roboterclubaachen/reflow-oven/README.md

# reflow-oven

Description: tbd

## Folder structure

#### `pcbs/pcb_name/`
* KiCad files of the PCBs

#### `src/test_*/`
* Test software. Useful during PCB assembly

#### `src/app/`
* Main Software

## License

Software is licensed under [GPLv3](LICENSE).
Hardware (PCB files, ...) is licensed under [CERN OHL v.1.2](LICENSE.hardware).
