roboterclubaachen/reflow-oven/UI_plane.FCStd

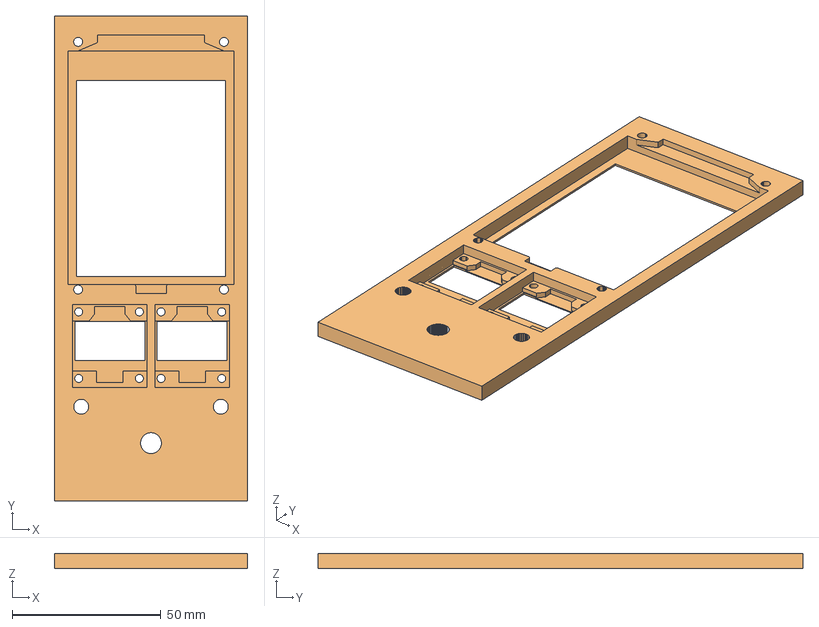
[picture p1: CAD file, 2024-09-06]
UI_plane.FCStd
65.0 x 163.1 x 5.10 mm
Body001 (Meshed)
