roboterclubaachen/reflow-oven/pcbs/reflow-controller-v1/reflow-controller-v1.kicad_pcb

## KiCad design pcbs/reflow-controller-v1/reflow-controller-v1.kicad_pcb (2024-09-22)

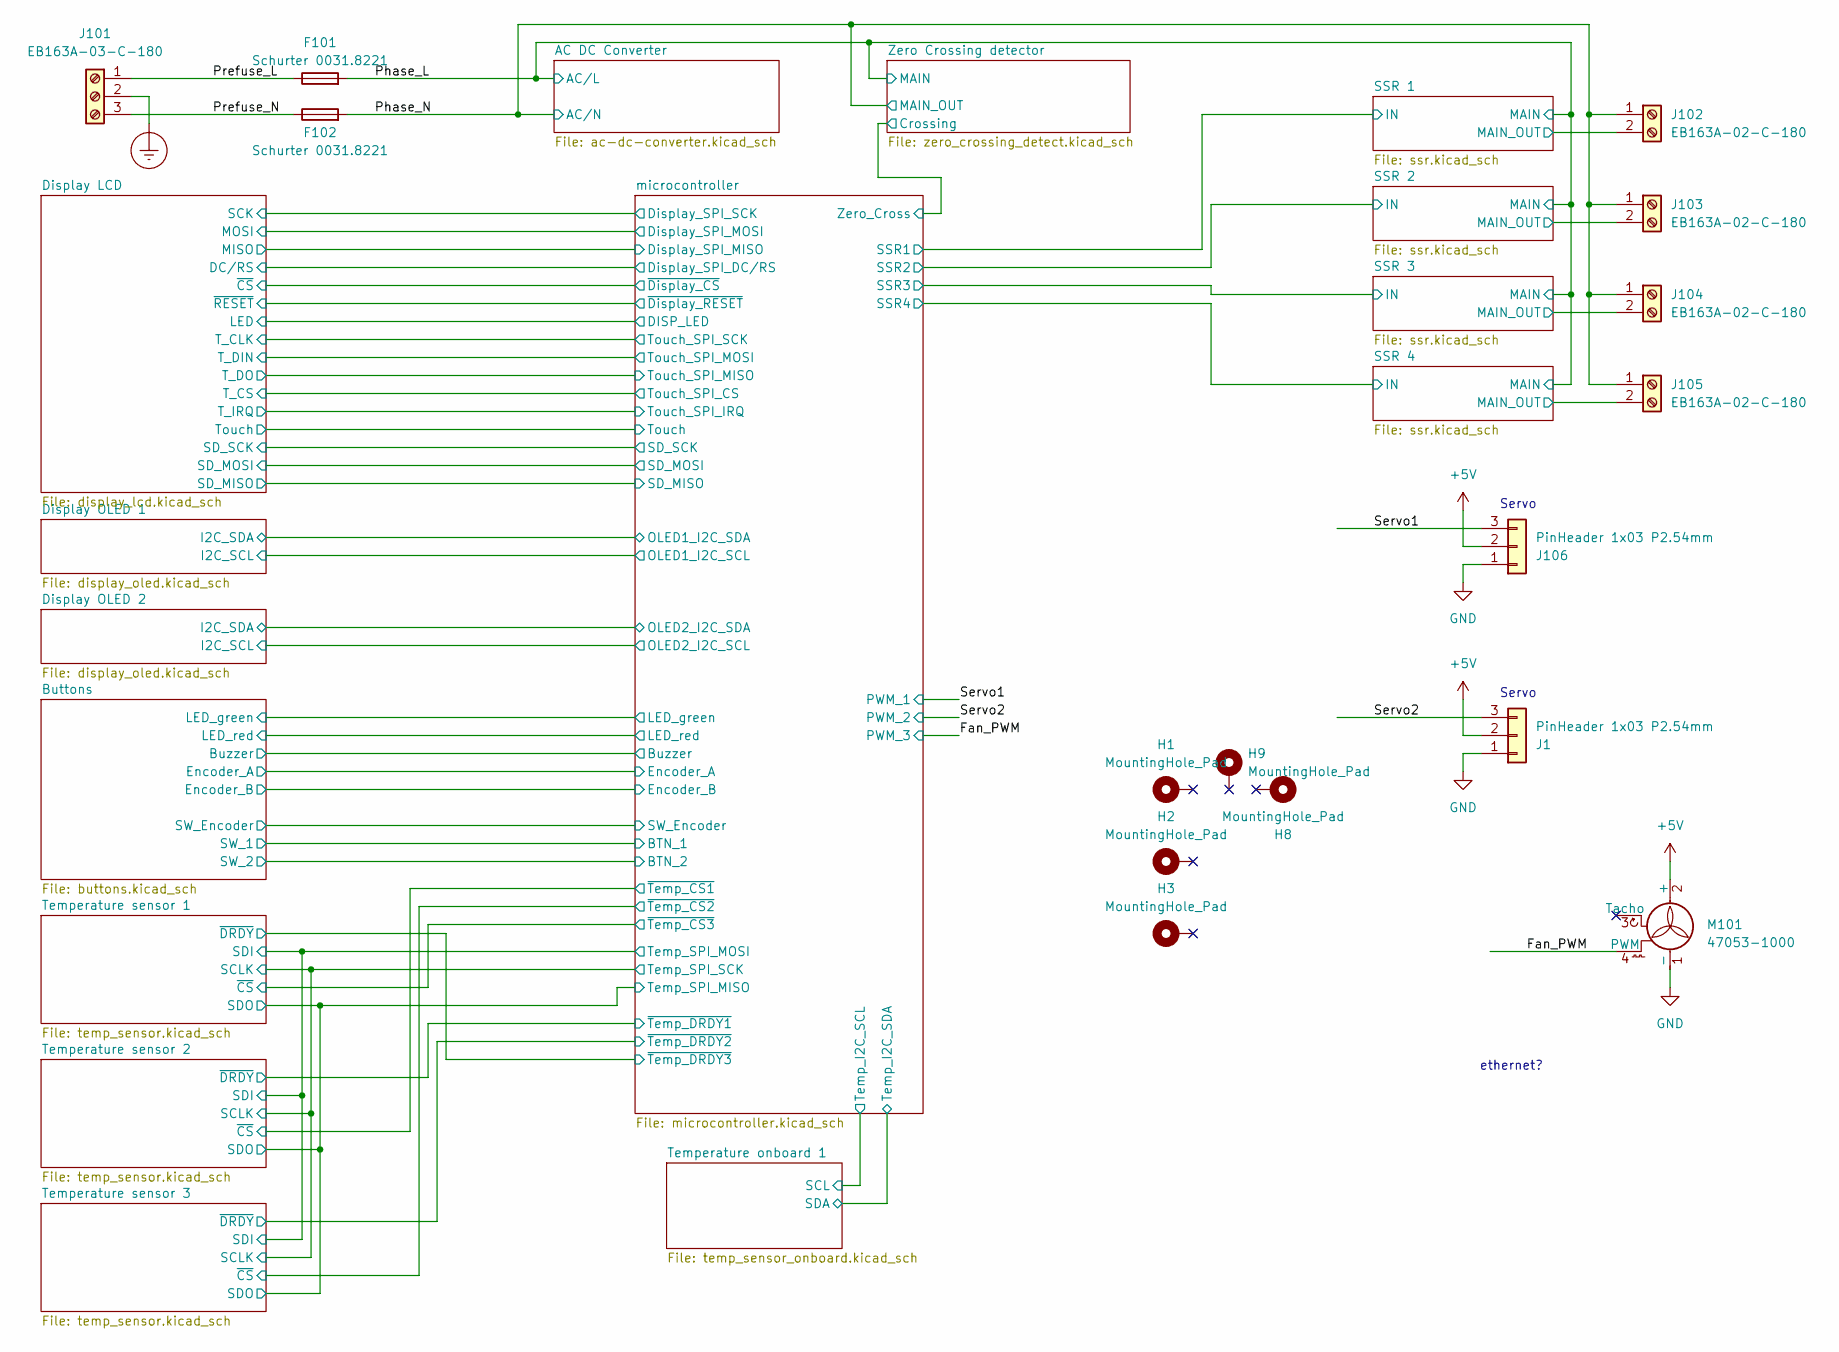
[picture p2: schematic reflow-controller-v1.kicad_sch]

Parts:
F101, F102: Schurter 0031.8221; Fuseholder_Cylinder-5x20mm_Schurter_OGN-SMD_Horizontal_Open
H1, H2, H3, H8, H9: MountingHole_Pad; Mounting_Wuerth_WA-SMSI-M3_H15mm_9774150360
J1, J106: PinHeader 1x03 P2.54mm; PinHeader_1x03_P2.54mm_Vertical
J101: EB163A-03-C-180; PhoenixContact_SPT_2.5_3-V-5.0-EX_1x03_P5.0mm_Vertical
J102, J103, J104, J105: EB163A-02-C-180; PhoenixContact_SPT_2.5_2-V-5.0-EX_1x02_P5.0mm_Vertical
M101: 47053-1000; Molex_KK-254_AE-6410-04A_1x04_P2.54mm_Vertical

Connections:
+5V: J1.2, J106.2, M101.2 (+); also elsewhere on the board
/Fan_PWM: M101.4 (PWM); also elsewhere on the board
/Phase_L: F101.2; also elsewhere on the board
/Phase_N: F102.2, J102.1, J103.1, J104.1, J105.1; also elsewhere on the board
/Prefuse_L: F101.1, J101.1
/Prefuse_N: F102.1, J101.3
/SSR 1/MAIN_OUT: J102.2; also elsewhere on the board
/SSR 2/MAIN_OUT: J103.2; also elsewhere on the board
/SSR 3/MAIN_OUT: J104.2; also elsewhere on the board
/SSR 4/MAIN_OUT: J105.2; also elsewhere on the board
/Servo1: J106.3; also elsewhere on the board
/Servo2: J1.3; also elsewhere on the board
Earth_Protective: J101.2
GND: J1.1, J106.1, M101.1 (-); also elsewhere on the board

Notes on the sheet:
Servo
ethernet?

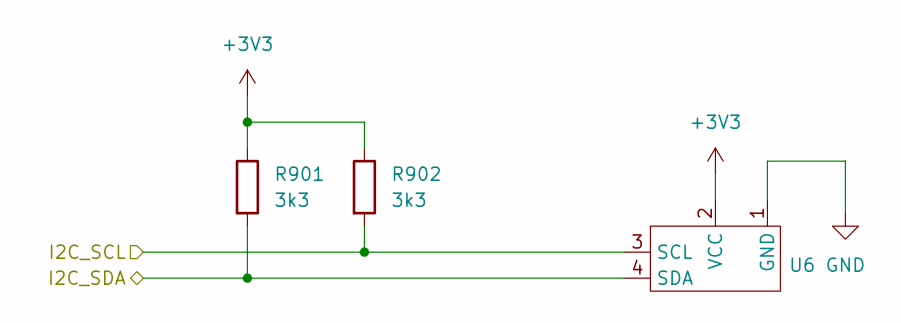
[picture p3: schematic display_oled.kicad_sch]

Parts:
R901, R902: 3k3; R_0603_1608Metric
U6: SSD1315 Module

Connections:
+3V3: R901.1, R902.1, U6.2 (VCC); also elsewhere on the board
/Display OLED 2/I2C_SCL: R902.2, U6.3 (SCL); also elsewhere on the board
/Display OLED 2/I2C_SDA: R901.2, U6.4 (SDA); also elsewhere on the board
GND: U6.1 (GND); also elsewhere on the board

Parts of its further copies:
R801, R802: 3k3; R_0603_1608Metric
U5: SSD1315 Module

Connections of its further copies:
+3V3: R801.1, R802.1, U5.2 (VCC); also elsewhere on the board
/Display OLED 1/I2C_SCL: R802.2, U5.3 (SCL); also elsewhere on the board
/Display OLED 1/I2C_SDA: R801.2, U5.4 (SDA); also elsewhere on the board
GND: U5.1 (GND); also elsewhere on the board

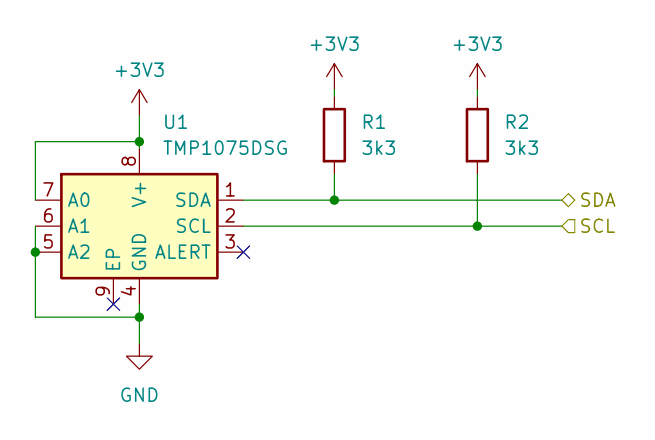
[picture p4: schematic temp_sensor_onboard.kicad_sch]

Parts:
R1, R2: 3k3; R_0603_1608Metric
U1: TMP1075DSG; WSON-8-1EP_2x2mm_P0.5mm_EP0.9x1.6mm_ThermalVias

Connections:
+3V3: R1.1, R2.1, U1.7 (A0), U1.8 (V+); also elsewhere on the board
/Temperature onboard 1/SCL: R2.2, U1.2 (SCL); also elsewhere on the board
/Temperature onboard 1/SDA: R1.2, U1.1 (SDA); also elsewhere on the board
GND: U1.4 (GND), U1.5 (A2), U1.6 (A1); also elsewhere on the board

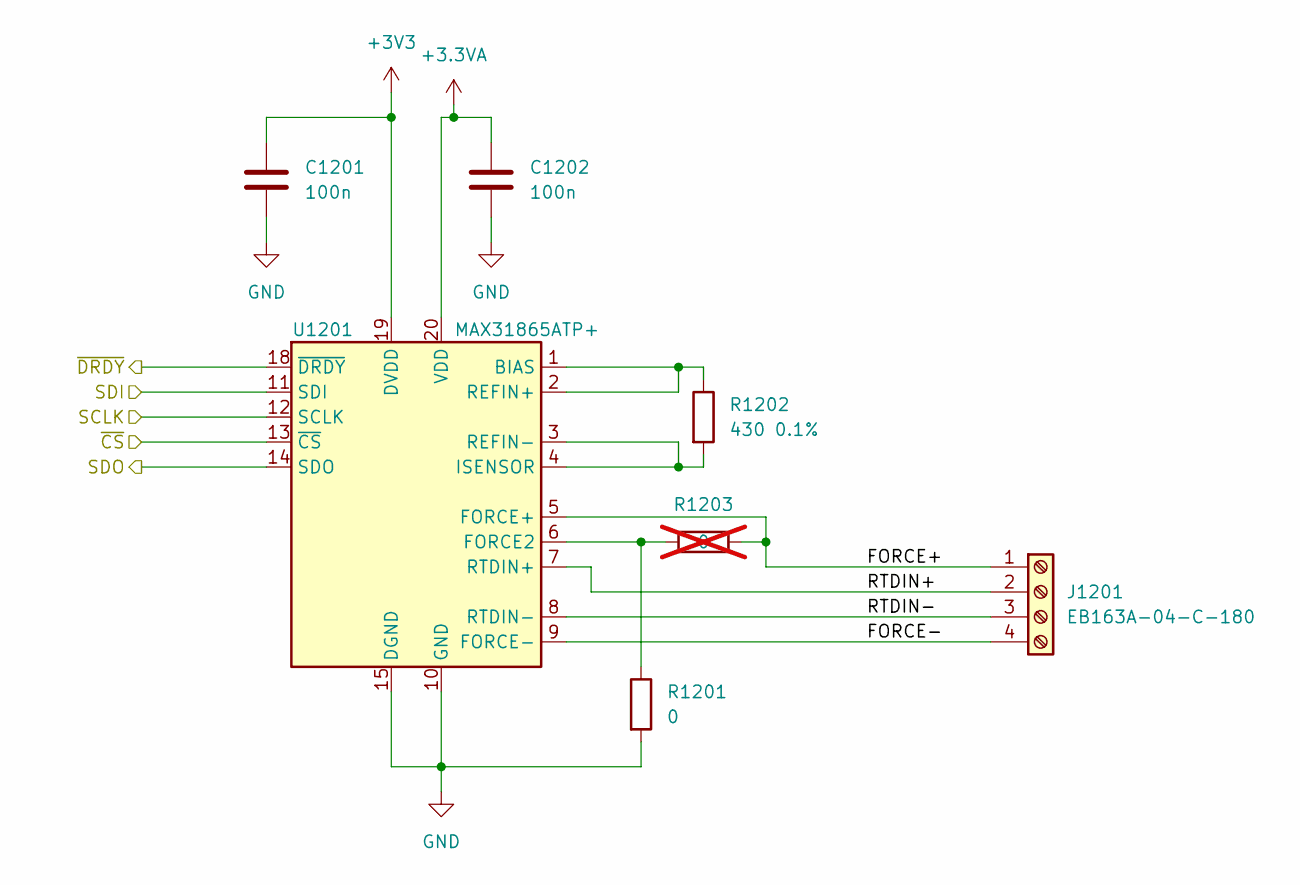
[picture p5: schematic temp_sensor.kicad_sch]

Parts:
C1201, C1202: 100n; C_0603_1608Metric
J1201: EB163A-04-C-180; PhoenixContact_SPT_2.5_4-V-5.0-EX_1x04_P5.0mm_Vertical
R1201: 0; R_0603_1608Metric
R1202: 430 0.1%; R_1206_3216Metric
R1203: 0; R_0603_1608Metric; not fitted
U1201: MAX31865ATP+; TQFN-20-1EP_5x5mm_P0.65mm_EP3.25x3.25mm

Connections:
+3.3VA: C1202.1, U1201.20 (VDD); also elsewhere on the board
+3V3: C1201.1, U1201.19 (DVDD); also elsewhere on the board
/Temperature sensor 1/SCLK: U1201.12 (SCLK); also elsewhere on the board
/Temperature sensor 1/SDI: U1201.11 (SDI); also elsewhere on the board
/Temperature sensor 1/SDO: U1201.14 (SDO); also elsewhere on the board
/Temperature sensor 2/FORCE+: J1201.1, R1203.2, U1201.5 (FORCE+)
/Temperature sensor 2/FORCE-: J1201.4, U1201.9 (FORCE-)
/Temperature sensor 2/RTDIN+: J1201.2, U1201.7 (RTDIN+)
/Temperature sensor 2/RTDIN-: J1201.3, U1201.8 (RTDIN-)
/Temperature sensor 2/~CS: U1201.13 (~CS); also elsewhere on the board
/Temperature sensor 2/~DRDY: U1201.18 (~DRDY); also elsewhere on the board
GND: C1201.2, C1202.2, R1201.2, U1201.10 (GND), U1201.15 (DGND), U1201.16 (GND), U1201.21 (GND); also elsewhere on the board
unnamed: R1202.1, U1201.1 (BIAS), U1201.2 (REFIN+)
unnamed: R1201.1, R1203.1, U1201.6 (FORCE2)
unnamed: R1202.2, U1201.3 (REFIN-), U1201.4 (ISENSOR)

Parts of its further copies:
C1101, C1102, C1301, C1302: 100n; C_0603_1608Metric
J1101, J1301: EB163A-04-C-180; PhoenixContact_SPT_2.5_4-V-5.0-EX_1x04_P5.0mm_Vertical
R1101, R1302: 430 0.1%; R_1206_3216Metric
R1102, R1301: 0; R_0603_1608Metric
R1103, R1303: 0; R_0603_1608Metric; not fitted
U1101, U1301: MAX31865ATP+; TQFN-20-1EP_5x5mm_P0.65mm_EP3.25x3.25mm

Connections of its further copies:
+3.3VA: C1101.1, C1302.1, U1101.20 (VDD), U1301.20 (VDD); also elsewhere on the board
+3V3: C1102.1, C1301.1, U1101.19 (DVDD), U1301.19 (DVDD); also elsewhere on the board
/Temperature sensor 1/FORCE+: J1101.1, R1103.2, U1101.5 (FORCE+)
/Temperature sensor 1/FORCE-: J1101.4, U1101.9 (FORCE-)
/Temperature sensor 1/RTDIN+: J1101.2, U1101.7 (RTDIN+)
/Temperature sensor 1/RTDIN-: J1101.3, U1101.8 (RTDIN-)
/Temperature sensor 1/SCLK: U1101.12 (SCLK), U1301.12 (SCLK); also elsewhere on the board
/Temperature sensor 1/SDI: U1101.11 (SDI), U1301.11 (SDI); also elsewhere on the board
/Temperature sensor 1/SDO: U1101.14 (SDO), U1301.14 (SDO); also elsewhere on the board
/Temperature sensor 1/~CS: U1101.13 (~CS); also elsewhere on the board
/Temperature sensor 1/~DRDY: U1101.18 (~DRDY); also elsewhere on the board
/Temperature sensor 3/FORCE+: J1301.1, R1303.2, U1301.5 (FORCE+)
/Temperature sensor 3/FORCE-: J1301.4, U1301.9 (FORCE-)
/Temperature sensor 3/RTDIN+: J1301.2, U1301.7 (RTDIN+)
/Temperature sensor 3/RTDIN-: J1301.3, U1301.8 (RTDIN-)
/Temperature sensor 3/~CS: U1301.13 (~CS); also elsewhere on the board
/Temperature sensor 3/~DRDY: U1301.18 (~DRDY); also elsewhere on the board
GND: C1101.2, C1102.2, C1301.2, C1302.2, R1102.2, R1301.2, U1101.10 (GND), U1101.15 (DGND), U1101.16 (GND), U1101.21 (GND), U1301.10 (GND), U1301.15 (DGND), U1301.16 (GND), U1301.21 (GND); also elsewhere on the board
unnamed: R1101.1, U1101.1 (BIAS), U1101.2 (REFIN+)
unnamed: R1102.1, R1103.1, U1101.6 (FORCE2)
unnamed: R1101.2, U1101.3 (REFIN-), U1101.4 (ISENSOR)
unnamed: R1302.1, U1301.1 (BIAS), U1301.2 (REFIN+)
unnamed: R1301.1, R1303.1, U1301.6 (FORCE2)
unnamed: R1302.2, U1301.3 (REFIN-), U1301.4 (ISENSOR)

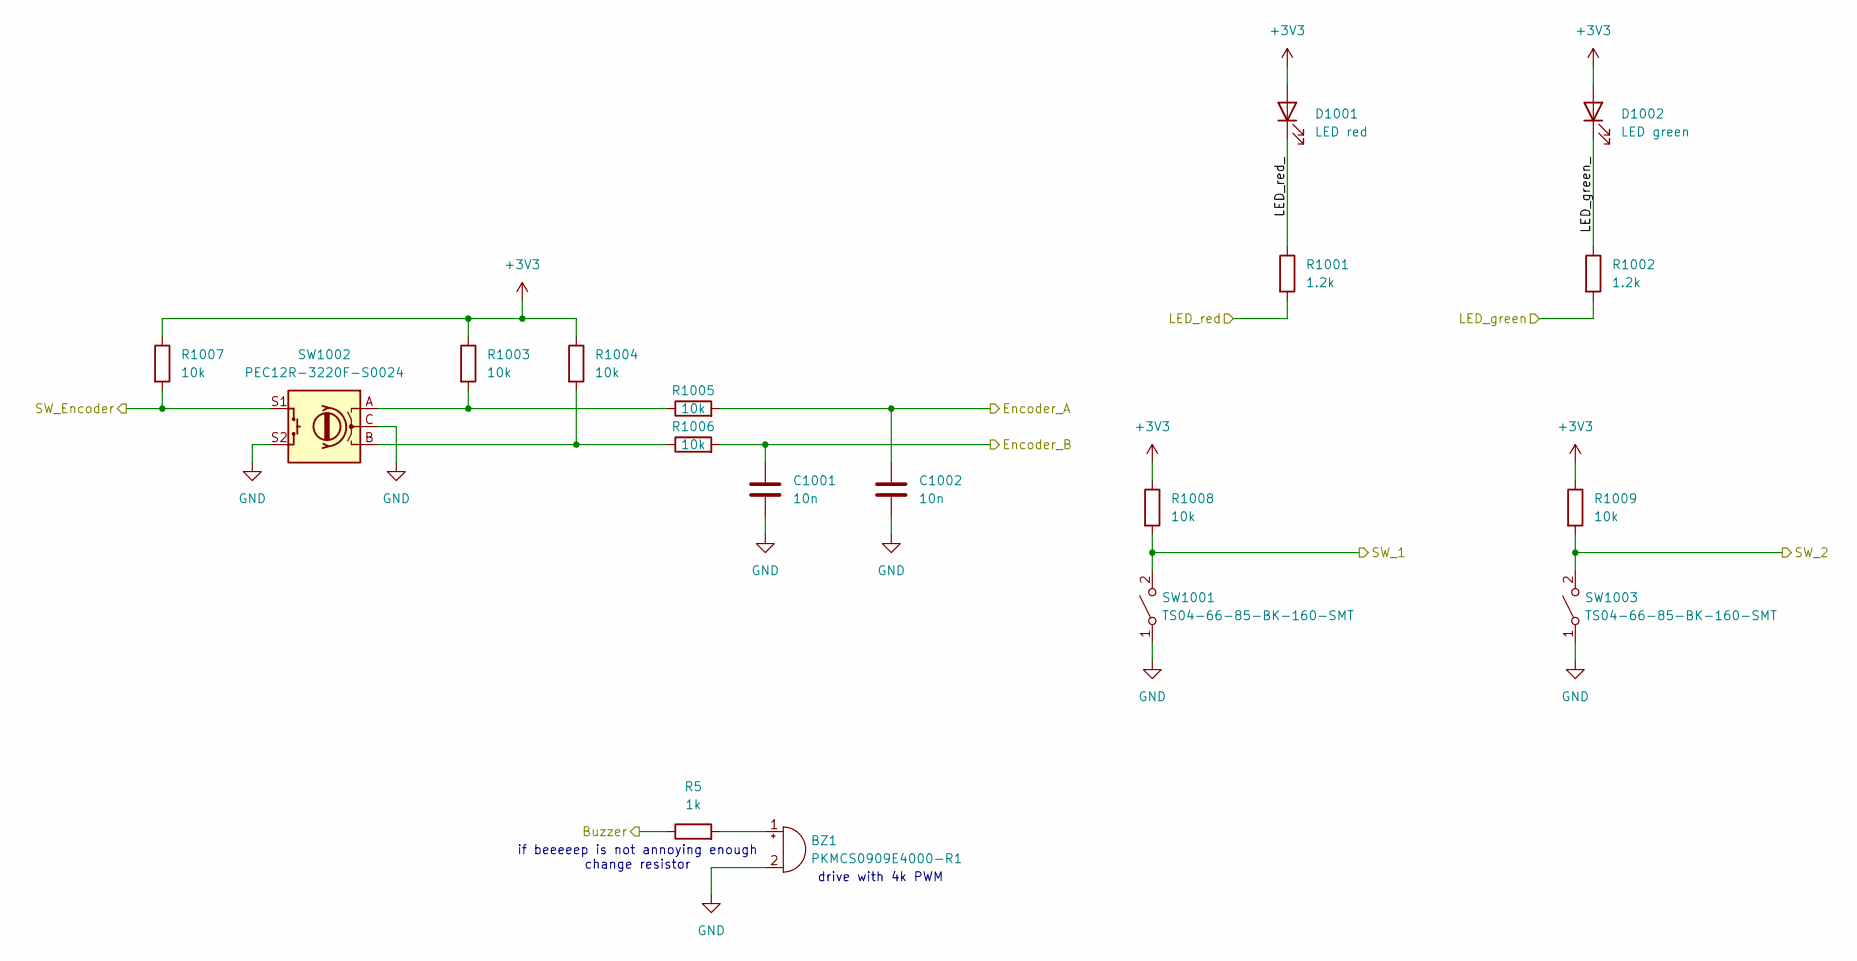
[picture p6: schematic buttons.kicad_sch]

Parts:
BZ1: PKMCS0909E4000-R1; Buzzer_Murata_PKMCS0909E
C1001, C1002: 10n; C_0603_1608Metric
D1001: LED red; LED_0603_1608Metric
D1002: LED green; LED_0603_1608Metric
R5: 1k; R_0603_1608Metric
R1001, R1002: 1.2k; R_0603_1608Metric
R1003, R1004, R1005, R1006, R1007, R1008, R1009: 10k; R_0603_1608Metric
SW1001, SW1003: TS04-66-85-BK-160-SMT; SW_Push_1P1T_NO_6x6mm_H9.5mm
SW1002: PEC12R-3220F-S0024; RotaryEncoder_Bourns_Vertical_PEC12R-3x17F-Sxxxx

Connections:
+3V3: D1001.2 (A), D1002.2 (A), R1003.1, R1004.1, R1007.1, R1008.1, R1009.1; also elsewhere on the board
/Buttons/Buzzer: R5.1; also elsewhere on the board
/Buttons/Encoder_A: C1002.1, R1005.2; also elsewhere on the board
/Buttons/Encoder_B: C1001.1, R1006.2; also elsewhere on the board
/Buttons/LED_green: R1002.2; also elsewhere on the board
/Buttons/LED_green_: D1002.1 (K), R1002.1
/Buttons/LED_red: R1001.2; also elsewhere on the board
/Buttons/LED_red_: D1001.1 (K), R1001.1
/Buttons/SW_1: R1008.2, SW1001.2 (B); also elsewhere on the board
/Buttons/SW_2: R1009.2, SW1003.2 (B); also elsewhere on the board
/Buttons/SW_Encoder: R1007.2, SW1002.S1; also elsewhere on the board
GND: BZ1.2 (-), C1001.2, C1002.2, SW1001.1 (A), SW1002.C, SW1002.S2, SW1003.1 (A); also elsewhere on the board
unnamed: BZ1.1 (+), R5.2
unnamed: R1003.2, R1005.1, SW1002.A
unnamed: R1004.2, R1006.1, SW1002.B

Notes on the sheet:
if beeeeep is not annoying enough change resistor
drive with 4k PWM

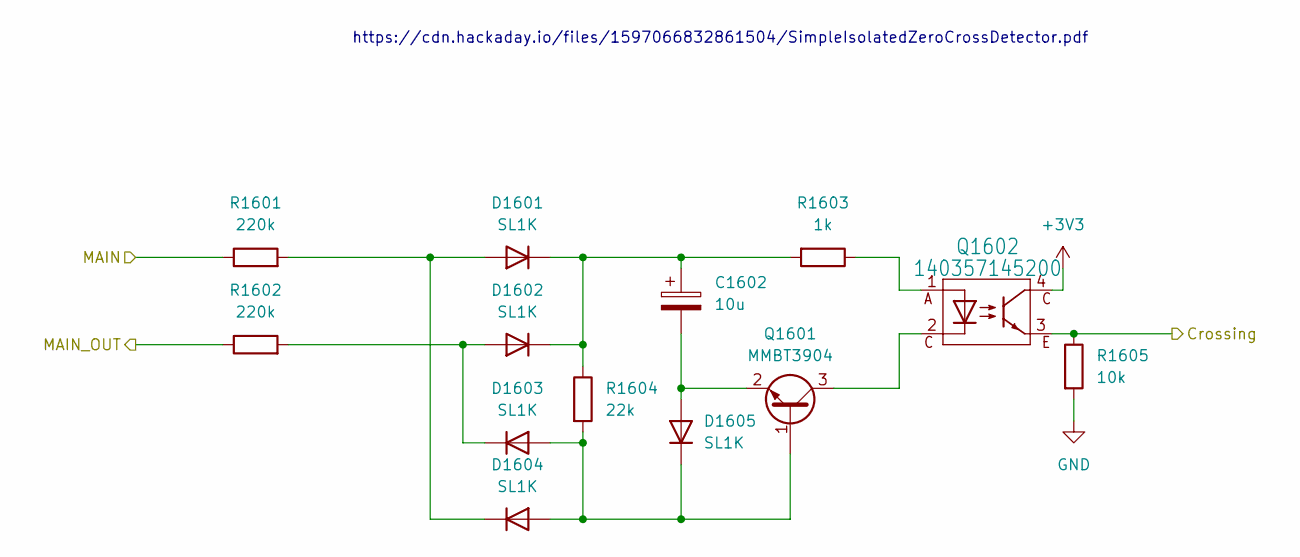
[picture p7: schematic zero_crossing_detect.kicad_sch]

Parts:
C1602: 10u; CP_Elec_4x5.7
D1601, D1602, D1603, D1604, D1605: SL1K; D_SOD-123F
Q1601: MMBT3904; SOT-23
Q1602: 140357145200; WL-OCPT_LSOP4
R1601, R1602: 220k; R_1206_3216Metric
R1603: 1k; R_0603_1608Metric
R1604: 22k; R_0603_1608Metric
R1605: 10k; R_0603_1608Metric

Connections:
+3V3: Q1602.4; also elsewhere on the board
/Phase_L: R1601.1; also elsewhere on the board
/Phase_N: R1602.1; also elsewhere on the board
/Zero Crossing detector/Crossing: Q1602.3, R1605.1; also elsewhere on the board
GND: R1605.2; also elsewhere on the board
unnamed: D1601.2 (A), D1604.1 (K), R1601.2
unnamed: C1602.1, D1601.1 (K), D1602.1 (K), R1603.2, R1604.1
unnamed: D1602.2 (A), D1603.1 (K), R1602.2
unnamed: D1603.2 (A), D1604.2 (A), D1605.1 (K), Q1601.1 (B), R1604.2
unnamed: C1602.2, D1605.2 (A), Q1601.2 (E)
unnamed: Q1601.3 (C), Q1602.2
unnamed: Q1602.1, R1603.1

Notes on the sheet:
https://cdn.hackaday.io/files/1597066832861504/SimpleIsolatedZeroCrossDetector.pdf

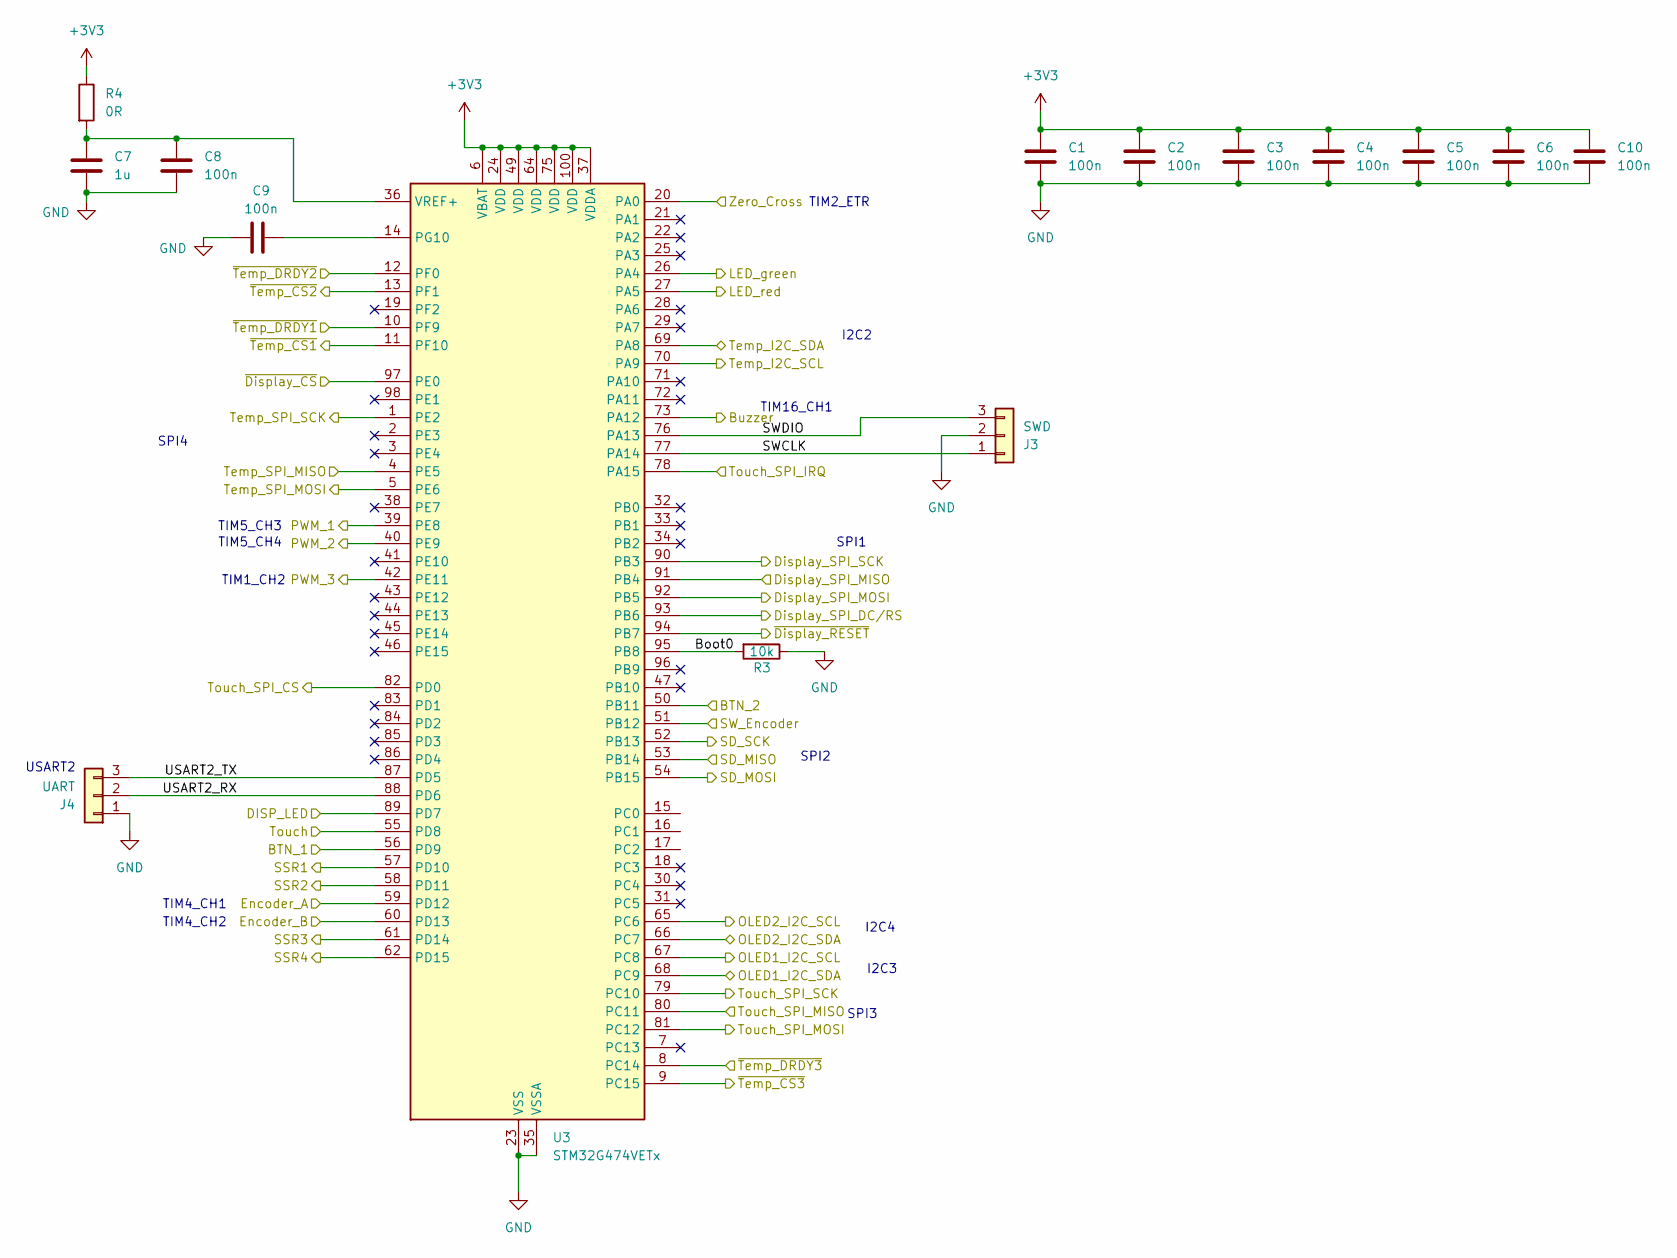
[picture p8: schematic microcontroller.kicad_sch]

Parts:
C1, C2, C3, C4, C5, C6, C8, C9, C10: 100n; C_0603_1608Metric
C7: 1u; C_0603_1608Metric
J3: SWD; Molex_KK-254_AE-6410-03A_1x03_P2.54mm_Vertical
J4: UART; Molex_KK-254_AE-6410-03A_1x03_P2.54mm_Vertical
R3: 10k; R_0603_1608Metric
R4: 0R; R_0603_1608Metric
U3: STM32G474VETx; LQFP-100_14x14mm_P0.5mm

Connections:
+3V3: C1.1, C2.1, C3.1, C4.1, C5.1, C6.1, C10.1, R4.1, U3.6 (VBAT), U3.24 (VDD), U3.37 (VDDA), U3.49 (VDD), U3.64 (VDD), U3.75 (VDD), U3.100 (VDD); also elsewhere on the board
/Buttons/Buzzer: U3.73 (PA12); also elsewhere on the board
/Buttons/Encoder_A: U3.59 (PD12); also elsewhere on the board
/Buttons/Encoder_B: U3.60 (PD13); also elsewhere on the board
/Buttons/LED_green: U3.26 (PA4); also elsewhere on the board
/Buttons/LED_red: U3.27 (PA5); also elsewhere on the board
/Buttons/SW_1: U3.56 (PD9); also elsewhere on the board
/Buttons/SW_2: U3.50 (PB11); also elsewhere on the board
/Buttons/SW_Encoder: U3.51 (PB12); also elsewhere on the board
/Display LCD/DC/RS: U3.93 (PB6); also elsewhere on the board
/Display LCD/LED: U3.89 (PD7); also elsewhere on the board
/Display LCD/MISO: U3.91 (PB4); also elsewhere on the board
/Display LCD/MOSI: U3.92 (PB5); also elsewhere on the board
/Display LCD/SCK: U3.90 (PB3); also elsewhere on the board
/Display LCD/SD_MISO: U3.53 (PB14); also elsewhere on the board
/Display LCD/SD_MOSI: U3.54 (PB15); also elsewhere on the board
/Display LCD/SD_SCK: U3.52 (PB13); also elsewhere on the board
/Display LCD/T_CLK: U3.79 (PC10); also elsewhere on the board
/Display LCD/T_CS: U3.82 (PD0); also elsewhere on the board
/Display LCD/T_DIN: U3.81 (PC12); also elsewhere on the board
/Display LCD/T_DO: U3.80 (PC11); also elsewhere on the board
/Display LCD/T_IRQ: U3.78 (PA15); also elsewhere on the board
/Display LCD/Touch: U3.55 (PD8); also elsewhere on the board
/Display LCD/~CS: U3.97 (PE0); also elsewhere on the board
/Display LCD/~RESET: U3.94 (PB7); also elsewhere on the board
/Display OLED 1/I2C_SCL: U3.67 (PC8); also elsewhere on the board
/Display OLED 1/I2C_SDA: U3.68 (PC9); also elsewhere on the board
/Display OLED 2/I2C_SCL: U3.65 (PC6); also elsewhere on the board
/Display OLED 2/I2C_SDA: U3.66 (PC7); also elsewhere on the board
/Fan_PWM: U3.42 (PE11); also elsewhere on the board
/SSR 1/IN: U3.57 (PD10); also elsewhere on the board
/SSR 2/IN: U3.58 (PD11); also elsewhere on the board
/SSR 3/IN: U3.61 (PD14); also elsewhere on the board
/SSR 4/IN: U3.62 (PD15); also elsewhere on the board
/Servo1: U3.39 (PE8); also elsewhere on the board
/Servo2: U3.40 (PE9); also elsewhere on the board
/Temperature onboard 1/SCL: U3.70 (PA9); also elsewhere on the board
/Temperature onboard 1/SDA: U3.69 (PA8); also elsewhere on the board
/Temperature sensor 1/SCLK: U3.1 (PE2); also elsewhere on the board
/Temperature sensor 1/SDI: U3.5 (PE6); also elsewhere on the board
/Temperature sensor 1/SDO: U3.4 (PE5); also elsewhere on the board
/Temperature sensor 1/~CS: U3.9 (PC15); also elsewhere on the board
/Temperature sensor 1/~DRDY: U3.8 (PC14); also elsewhere on the board
/Temperature sensor 2/~CS: U3.11 (PF10); also elsewhere on the board
/Temperature sensor 2/~DRDY: U3.10 (PF9); also elsewhere on the board
/Temperature sensor 3/~CS: U3.13 (PF1); also elsewhere on the board
/Temperature sensor 3/~DRDY: U3.12 (PF0); also elsewhere on the board
/Zero Crossing detector/Crossing: U3.20 (PA0); also elsewhere on the board
/microcontroller/Boot0: R3.2, U3.95 (PB8)
/microcontroller/SWCLK: J3.1, U3.77 (PA14)
/microcontroller/SWDIO: J3.3, U3.76 (PA13)
/microcontroller/USART2_RX: J4.2, U3.88 (PD6)
/microcontroller/USART2_TX: J4.3, U3.87 (PD5)
GND: C1.2, C2.2, C3.2, C4.2, C5.2, C6.2, C7.2, C8.2, C9.1, C10.2, J3.2, J4.1, R3.1, U3.23 (VSS), U3.35 (VSSA), U3.48 (VSS), U3.63 (VSS), U3.74 (VSS), U3.99 (VSS); also elsewhere on the board
unnamed: C9.2, U3.14 (PG10)
unnamed: C7.1, C8.1, R4.2, U3.36 (VREF+)

Notes on the sheet:
SPI4
TIM2_ETR
TIM5_CH3
TIM4_CH2
SPI3
I2C4
I2C2
SPI2
TIM16_CH1
TIM4_CH1
SPI1
I2C3
USART2
TIM5_CH4
TIM1_CH2

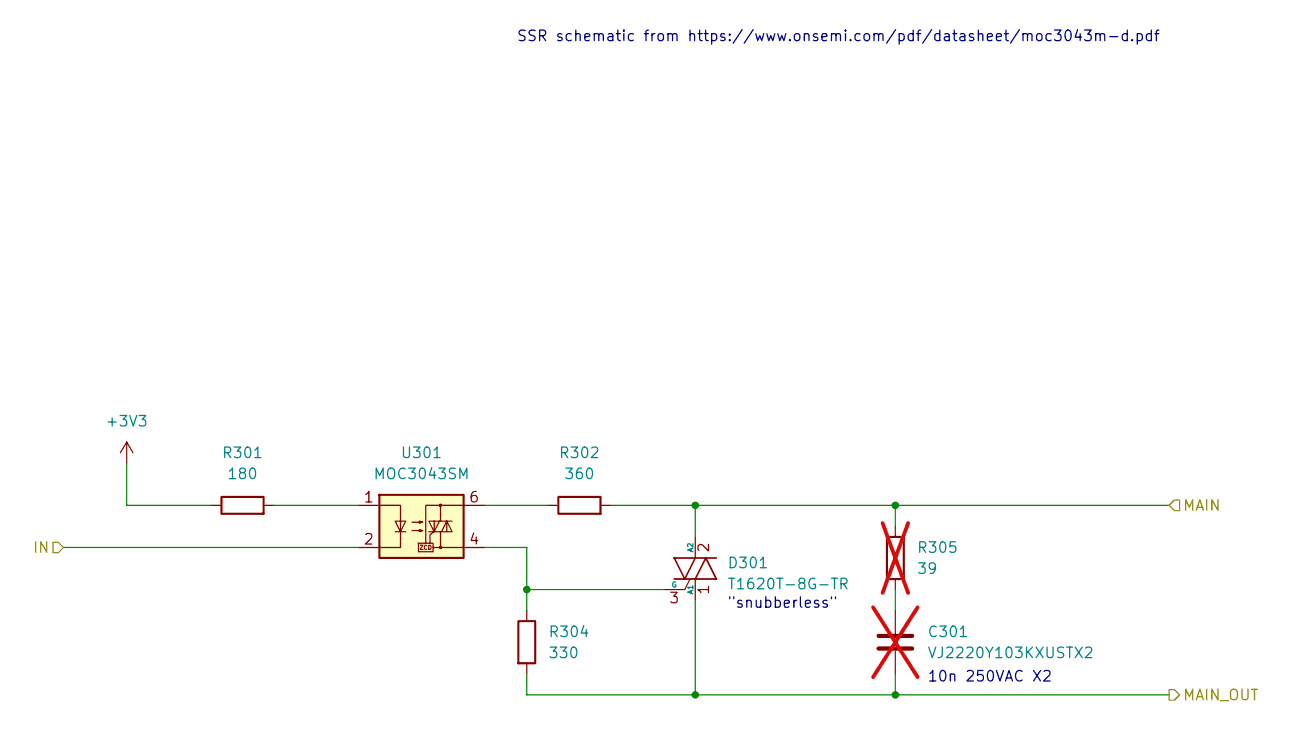
[picture p9: schematic ssr.kicad_sch]

Parts:
C301: VJ2220Y103KXUSTX2; C_2220_5750Metric; not fitted
D301: T1620T-8G-TR; TO-263-2
R301: 180; R_0603_1608Metric
R302: 360; R_1206_3216Metric
R304: 330; R_1206_3216Metric
R305: 39; R_1206_3216Metric; not fitted
U301: MOC3043SM; DIP-6_W7.62mm_SMDSocket_SmallPads

Connections:
+3V3: R301.1; also elsewhere on the board
/Phase_L: D301.2 (A2), R302.2, R305.1; also elsewhere on the board
/SSR 1/IN: U301.2; also elsewhere on the board
/SSR 1/MAIN_OUT: C301.2, D301.1 (A1), R304.2; also elsewhere on the board
unnamed: C301.1, R305.2
unnamed: D301.3 (G), R304.1, U301.4
unnamed: R301.2, U301.1
unnamed: R302.1, U301.6

Parts of its further copies:
C401, C501, C601: VJ2220Y103KXUSTX2; C_2220_5750Metric; not fitted
D401, D501, D601: T1620T-8G-TR; TO-263-2
R401, R501, R601: 180; R_0603_1608Metric
R402, R502, R602: 330; R_1206_3216Metric
R403, R503, R603: 360; R_1206_3216Metric
R404, R504, R604: 39; R_1206_3216Metric; not fitted
U401, U501, U601: MOC3043SM; DIP-6_W7.62mm_SMDSocket_SmallPads

Connections of its further copies:
+3V3: R401.1, R501.1, R601.1; also elsewhere on the board
/Phase_L: D401.2 (A2), D501.2 (A2), D601.2 (A2), R403.2, R404.1, R503.2, R504.1, R603.2, R604.1; also elsewhere on the board
/SSR 2/IN: U401.2; also elsewhere on the board
/SSR 2/MAIN_OUT: C401.2, D401.1 (A1), R402.2; also elsewhere on the board
/SSR 3/IN: U501.2; also elsewhere on the board
/SSR 3/MAIN_OUT: C501.2, D501.1 (A1), R502.2; also elsewhere on the board
/SSR 4/IN: U601.2; also elsewhere on the board
/SSR 4/MAIN_OUT: C601.2, D601.1 (A1), R602.2; also elsewhere on the board
unnamed: C401.1, R404.2
unnamed: C501.1, R504.2
unnamed: C601.1, R604.2
unnamed: D401.3 (G), R402.1, U401.4
unnamed: D501.3 (G), R502.1, U501.4
unnamed: D601.3 (G), R602.1, U601.4
unnamed: R401.2, U401.1
unnamed: R403.1, U401.6
unnamed: R501.2, U501.1
unnamed: R503.1, U501.6
unnamed: R601.2, U601.1
unnamed: R603.1, U601.6

Notes on the sheet:
"snubberless"
SSR schematic from https://www.onsemi.com/pdf/datasheet/moc3043m-d.pdf
10n 250VAC X2

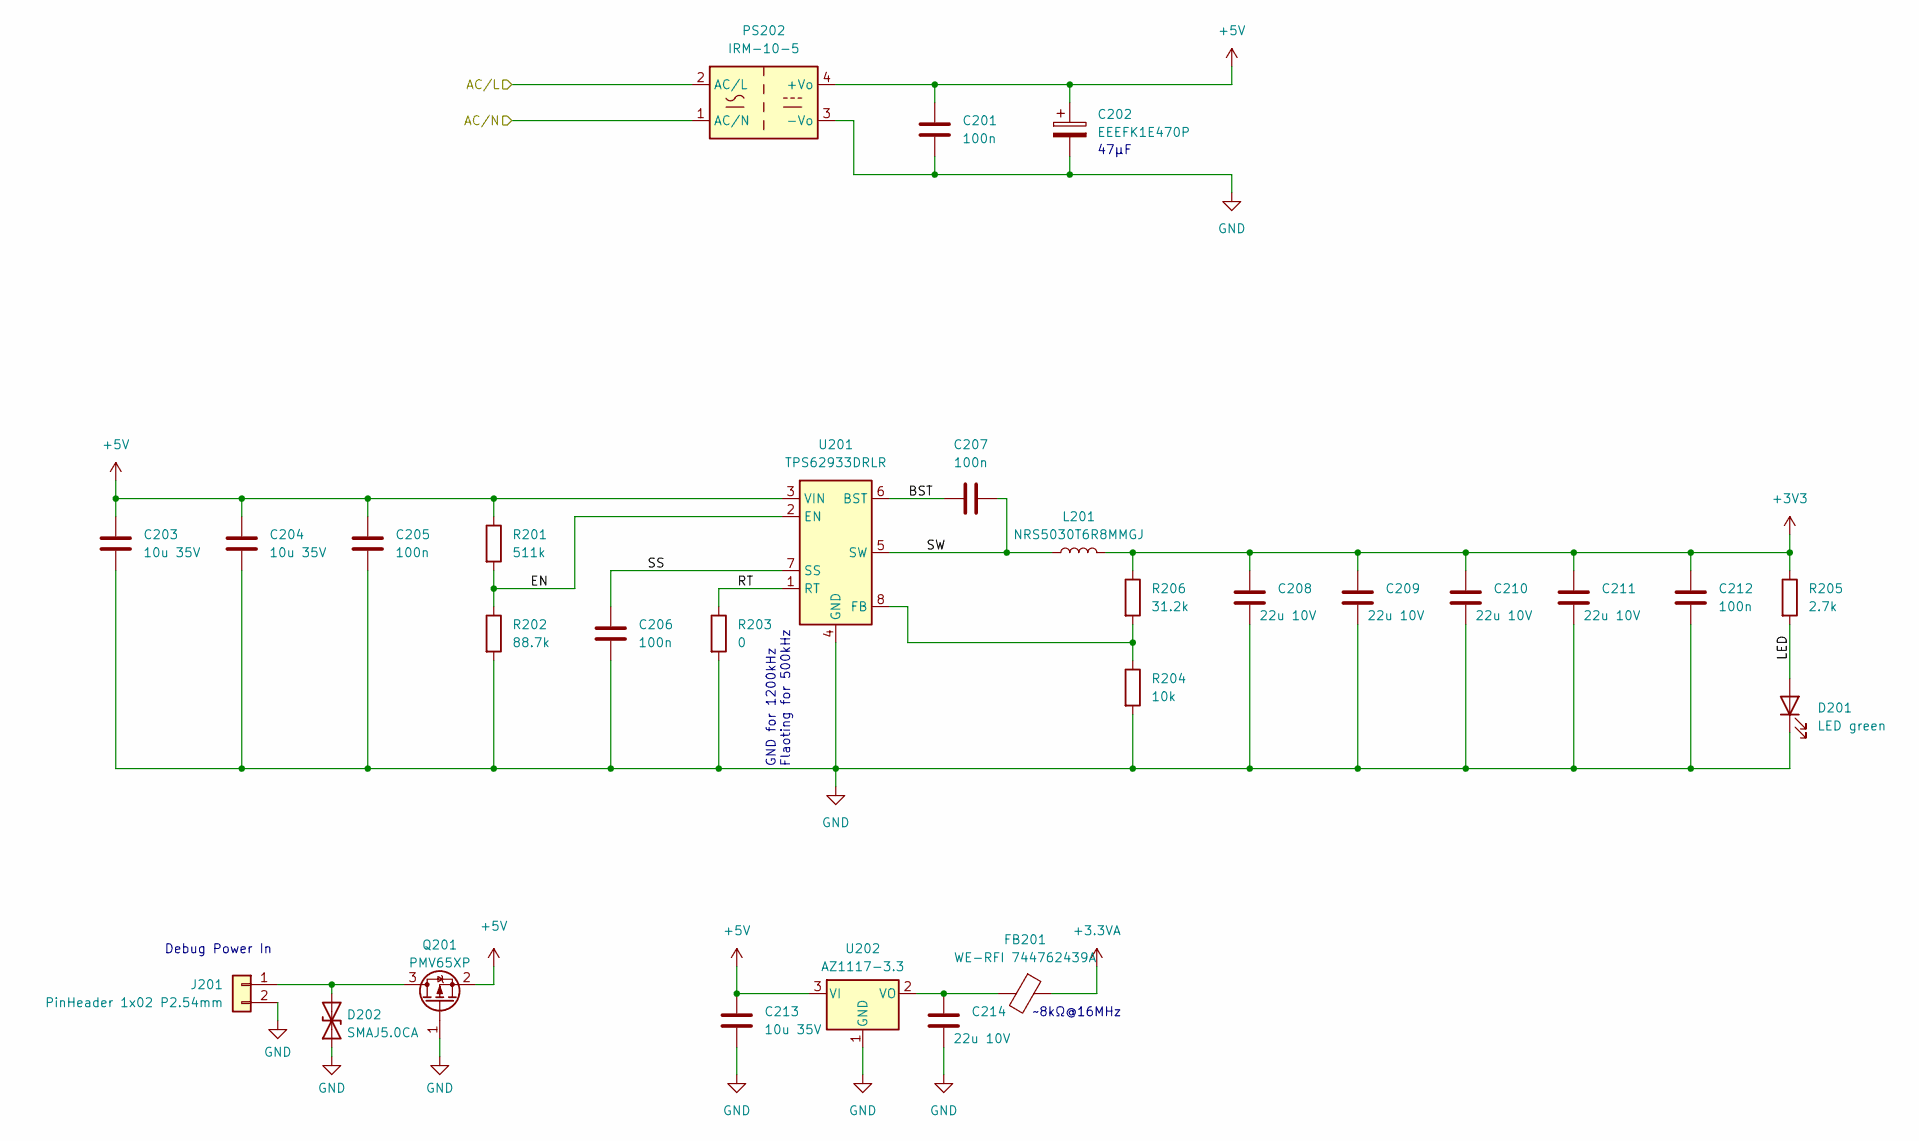
[picture p10: schematic ac-dc-converter.kicad_sch]

Parts:
C201, C205, C206, C207, C212: 100n; C_0603_1608Metric
C202: EEEFK1E470P; CP_Elec_6.3x5.9
C203, C204, C213: 10u 35V; C_1206_3216Metric
C208, C209, C210, C211, C214: 22u 10V; C_1206_3216Metric
D201: LED green; LED_0603_1608Metric
D202: SMAJ5.0CA; D_SMA
FB201: WE-RFI 744762439A; L_1008_2520Metric
J201: PinHeader 1x02 P2.54mm; Molex_KK-254_AE-6410-02A_1x02_P2.54mm_Vertical
L201: NRS5030T6R8MMGJ; L_Taiyo-Yuden_NR-50xx
PS202: IRM-10-5; Converter_ACDC_MeanWell_IRM-10-xx_THT
Q201: PMV65XP; SOT-23
R201: 511k; R_0603_1608Metric
R202: 88.7k; R_0603_1608Metric
R203: 0; R_0603_1608Metric
R204: 10k; R_0603_1608Metric
R205: 2.7k; R_0603_1608Metric
R206: 31.2k; R_0603_1608Metric
U201: TPS62933DRLR; SOT-583-8
U202: AZ1117-3.3; SOT-223-3_TabPin2

Connections:
+3.3VA: FB201.1; also elsewhere on the board
+3V3: C208.1, C209.1, C210.1, C211.1, C212.1, L201.2, R205.1, R206.1; also elsewhere on the board
+5V: C201.1, C202.1, C203.1, C204.1, C205.1, C213.1, PS202.4 (+Vo), Q201.2 (S), R201.1, U201.3 (VIN), U202.3 (VI); also elsewhere on the board
/AC DC Converter/BST: C207.1, U201.6 (BST)
/AC DC Converter/EN: R201.2, R202.1, U201.2 (EN)
/AC DC Converter/LED: D201.2 (A), R205.2
/AC DC Converter/RT: R203.1, U201.1 (RT)
/AC DC Converter/SS: C206.1, U201.7 (SS)
/AC DC Converter/SW: C207.2, L201.1, U201.5 (SW)
/Phase_L: PS202.2 (AC/L); also elsewhere on the board
/Phase_N: PS202.1 (AC/N); also elsewhere on the board
GND: C201.2, C202.2, C203.2, C204.2, C205.2, C206.2, C208.2, C209.2, C210.2, C211.2, C212.2, C213.2, C214.2, D201.1 (K), D202.1 (A1), J201.2, PS202.3 (-Vo), Q201.1 (G), R202.2, R203.2, R204.2, U201.4 (GND), U202.1 (GND); also elsewhere on the board
unnamed: D202.2 (A2), J201.1, Q201.3 (D)
unnamed: R204.1, R206.2, U201.8 (FB)
unnamed: C214.1, FB201.2, U202.2 (VO)

Notes on the sheet:
~8kΩ@16MHz
Debug Power In
GND for 1200kHz Flaoting for 500kHz
47µF

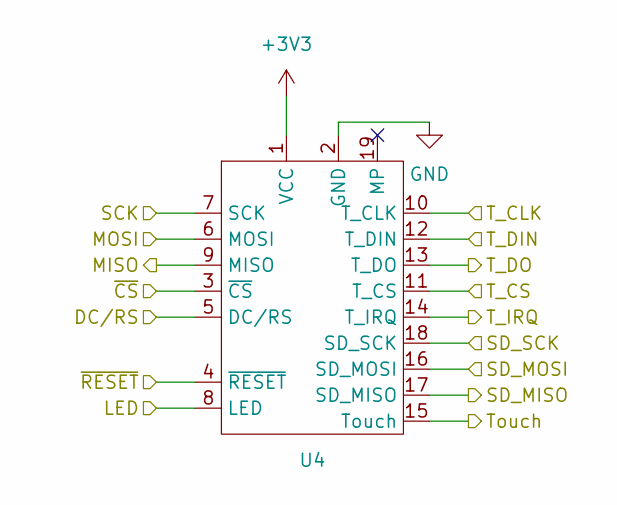
[picture p11: schematic display_lcd.kicad_sch]

Parts:
U4: ILI9341 Module

Connections:
+3V3: U4.1 (VCC); also elsewhere on the board
/Display LCD/DC/RS: U4.5 (DC/RS); also elsewhere on the board
/Display LCD/LED: U4.8 (LED); also elsewhere on the board
/Display LCD/MISO: U4.9 (MISO); also elsewhere on the board
/Display LCD/MOSI: U4.6 (MOSI); also elsewhere on the board
/Display LCD/SCK: U4.7 (SCK); also elsewhere on the board
/Display LCD/SD_MISO: U4.17 (SD_MISO); also elsewhere on the board
/Display LCD/SD_MOSI: U4.16 (SD_MOSI); also elsewhere on the board
/Display LCD/SD_SCK: U4.18 (SD_SCK); also elsewhere on the board
/Display LCD/T_CLK: U4.10 (T_CLK); also elsewhere on the board
/Display LCD/T_CS: U4.11 (T_CS); also elsewhere on the board
/Display LCD/T_DIN: U4.12 (T_DIN); also elsewhere on the board
/Display LCD/T_DO: U4.13 (T_DO); also elsewhere on the board
/Display LCD/T_IRQ: U4.14 (T_IRQ); also elsewhere on the board
/Display LCD/Touch: U4.15 (Touch); also elsewhere on the board
/Display LCD/~CS: U4.3 (~CS); also elsewhere on the board
/Display LCD/~RESET: U4.4 (~RESET); also elsewhere on the board
GND: U4.2 (GND); also elsewhere on the board
