roboterclubaachen/reflow-oven/pcbs/reflow-controller-v1/reflow-controller-v1.kicad_pcb

## KiCad design pcbs/reflow-controller-v1/reflow-controller-v1.kicad_pcb (continued)

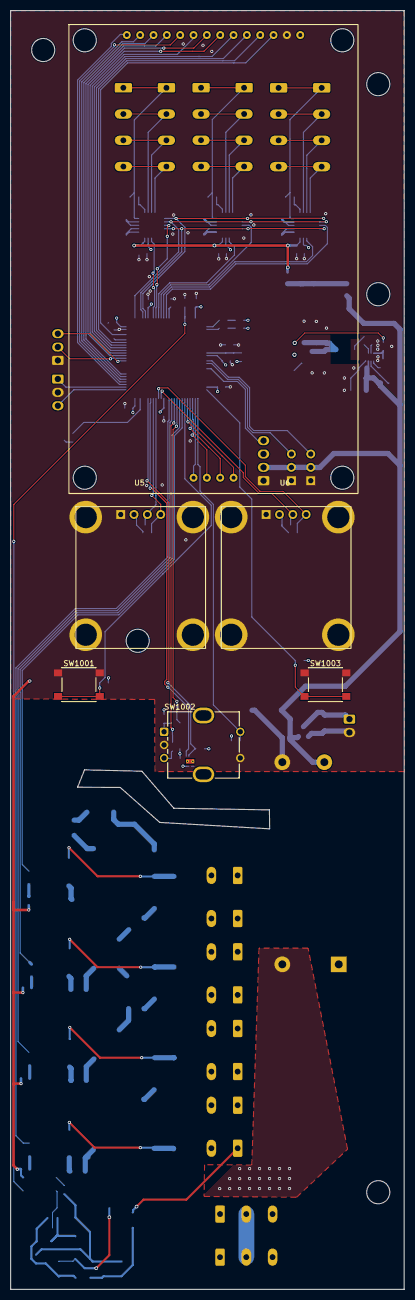
[picture p12: board reflow-controller-v1.kicad_pcb from above]

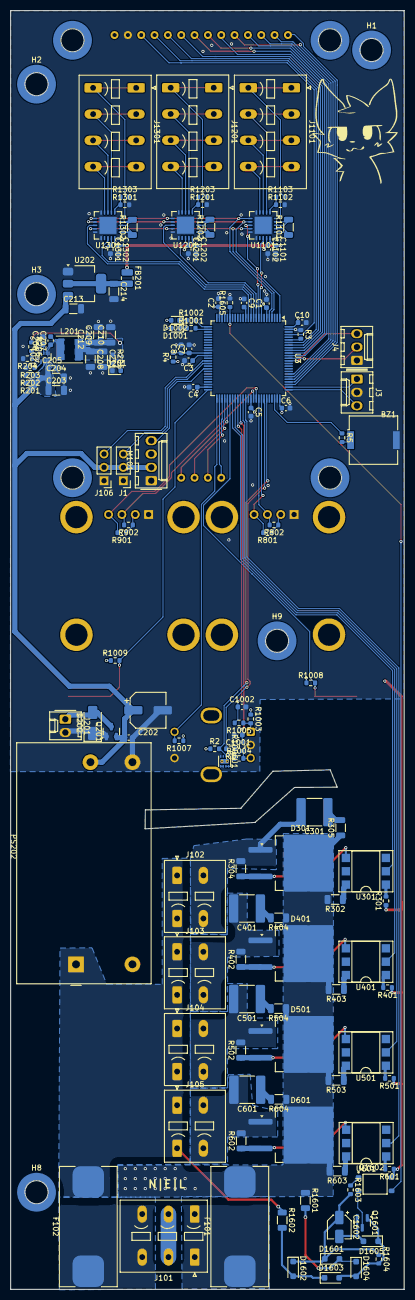
[picture p13: board reflow-controller-v1.kicad_pcb from below]

Board: 4 copper layers, 74.9 x 243.5 mm, 149 parts (143 on the bottom side), 124 nets.
