roboterclubaachen/reflow-oven/pcbs/reflow-controller-v1/reflow-oven.ioc

Mcu.UserName=STM32G474VETx
PA0.Signal=S_TIM2_ETR
PA12.Signal=S_TIM16_CH1
PA13.Signal=SYS_JTMS-SWDIO
PA14.Signal=SYS_JTCK-SWCLK
PA15.Signal=GPIO_Input
PA4.Signal=GPIO_Output
PA5.Signal=GPIO_Output
PA8.Signal=I2C2_SDA
PA9.Signal=I2C2_SCL
PB11.Signal=GPIO_Input
PB12.Signal=GPIO_Input
PB13.Signal=SPI2_SCK
PB14.Signal=SPI2_MISO
PB15.Signal=SPI2_MOSI
PB3.Signal=SPI1_SCK
PB4.Signal=SPI1_MISO
PB5.Signal=SPI1_MOSI
PB6.Signal=GPIO_Output
PB7.Signal=GPIO_Output
PB8-BOOT0.Signal=GPIO_Input
PC10.Signal=SPI3_SCK
PC11.Signal=SPI3_MISO
PC12.Signal=SPI3_MOSI
PC14-OSC32_IN.Signal=GPIO_Input
PC15-OSC32_OUT.Signal=GPIO_Output
PC6.Signal=I2C4_SCL
PC7.Signal=I2C4_SDA
PC8.Signal=I2C3_SCL
PC9.Signal=I2C3_SDA
PD0.Signal=GPIO_Output
PD10.Signal=GPIO_Input
PD11.Signal=GPIO_Input
PD12.Signal=S_TIM4_CH1
PD13.Signal=S_TIM4_CH2
PD14.Signal=GPIO_Output
PD15.Signal=GPIO_Output
PD5.Signal=USART2_TX
PD6.Signal=USART2_RX
PD7.Signal=GPIO_Output
PD8.Signal=GPIO_Input
PD9.Signal=GPIO_Input
PE0.Signal=GPIO_Input
PE11.Signal=S_TIM1_CH2
PE2.Signal=SPI4_SCK
PE5.Signal=SPI4_MISO
PE6.Signal=SPI4_MOSI
PE8.Signal=S_TIM5_CH3
PE9.Signal=S_TIM5_CH4
PF0-OSC_IN.Signal=GPIO_Input
PF1-OSC_OUT.Signal=GPIO_Output
PF10.Signal=GPIO_Output
PF9.Signal=GPIO_Input
PG10-NRST.Signal=GPIO_Input
