roboterclubaachen/reflow-oven/(commit log)

2023-08-22 [pcbs] reflow-controller-v1: Schematic created
    [ac-dc-converter.kicad_sch, buttons.kicad_sch, display_lcd.kicad_sch, display_oled.kicad_sch, reflow-controller-v1.kicad_pcb, reflow-controller-v1.kicad_sch, ssr.kicad_sch, temp_sensor.kicad_sch]
2024-03-19 added temp sensor
    [buttons.kicad_sch, display_lcd.kicad_sch, reflow-controller-v1.kicad_sch, temp_sensor_onboard.kicad_sch]
2024-07-02 kicad version bump
    [ac-dc-converter.kicad_sch, buttons.kicad_sch, display_lcd.kicad_sch, display_oled.kicad_sch, microcontroller.kicad_sch, reflow-controller-v1.kicad_sch, ssr.kicad_sch, temp_sensor.kicad_sch]
2024-07-02 footprint assignement fixed; buzzer added
    [ac-dc-converter.kicad_sch, buttons.kicad_sch, display_lcd.kicad_sch, display_oled.kicad_sch, microcontroller.kicad_sch, reflow-controller-v1.kicad_pcb, reflow-controller-v1.kicad_sch, ssr.kicad_sch]
2024-07-04 [pcbs] Add initial placement
    [buttons.kicad_sch, reflow-controller-v1.kicad_pcb]
2024-07-09 SSR schematic: add link to datasheet/reference schematic
    [ssr.kicad_sch]
2024-07-10 [pcb] move most smd parts to bottom layer
    [reflow-controller-v1.kicad_pcb]
2024-07-17 Adjust design rules: remove small trace and via sizes
    [reflow-controller-v1.kicad_pcb]
2024-07-19 add debug power input
    [reflow-controller-v1.kicad_sch]
2024-07-30 WIP pcb design & routing
    [ac-dc-converter.kicad_sch, display_lcd.kicad_sch, display_oled.kicad_sch, microcontroller.kicad_sch, reflow-controller-v1.kicad_pcb, reflow-controller-v1.kicad_sch]
2024-07-31 update routing with new mechanical positioning
    [microcontroller.kicad_sch, reflow-controller-v1.kicad_pcb, reflow-controller-v1.kicad_sch]
2024-07-31 increase isolation distance
    [reflow-controller-v1.kicad_pcb]
2024-08-03 add debug uart & swd
    [microcontroller.kicad_sch, reflow-controller-v1.kicad_pcb]
2024-08-03 update debug power footprint
    [ac-dc-converter.kicad_sch, reflow-controller-v1.kicad_pcb]
2024-08-04 label uart & swd
    [microcontroller.kicad_sch, reflow-controller-v1.kicad_pcb]
2024-08-04 move Fan PWM to different timer
    [microcontroller.kicad_sch]
2024-08-04 add labels to specify encoder periferal
    [microcontroller.kicad_sch]
2024-08-04 add labels to specify buzzer periferal
    [microcontroller.kicad_sch]
2024-08-04 correct false pin directions
    [display_lcd.kicad_sch, microcontroller.kicad_sch, reflow-controller-v1.kicad_sch]
2024-08-12 implement first layout feedback
    [reflow-controller-v1.kicad_pcb]
2024-08-13 improve dfn qfn fanouts
    [reflow-controller-v1.kicad_pcb]
2024-08-13 move beeper
    [microcontroller.kicad_sch, reflow-controller-v1.kicad_pcb]
2024-08-14 add zero crossing detector
    [ac-dc-converter.kicad_sch, microcontroller.kicad_sch, reflow-controller-v1.kicad_pcb, reflow-controller-v1.kicad_sch, zero_crossing_detect.kicad_sch]
2024-08-15 fix zero crossing detector 3.3 voltage supply
    [zero_crossing_detect.kicad_sch]
2024-08-15 add ldo for analog voltage
    [ac-dc-converter.kicad_sch, reflow-controller-v1.kicad_pcb, temp_sensor.kicad_sch]
2024-08-15 move misplaced 5V output caps
    [reflow-controller-v1.kicad_pcb]
2024-08-15 update analog voltage ldo placement&routing
    [ac-dc-converter.kicad_sch, reflow-controller-v1.kicad_pcb, temp_sensor.kicad_sch]
2024-08-15 improve powerdelivery to optotriacs
    [reflow-controller-v1.kicad_pcb]
2024-08-15 add clear border between HV&LV
    [reflow-controller-v1.kicad_pcb]
2024-08-24 design test ui plane for fitting&positioning of the displays
    [UI_plane.FCStd]
2024-08-24 update pcb size&display positioning
    [microcontroller.kicad_sch, reflow-controller-v1.kicad_pcb, temp_sensor.kicad_sch]
2024-09-04 update hv placment&routing + add initiall hv lv seperation
    [reflow-controller-v1.kicad_pcb, temp_sensor_onboard.kicad_sch]
2024-09-06 update display placing & prelim. routing
    [UI_plane.FCStd, ac-dc-converter.kicad_sch, buttons.kicad_sch, display_lcd.kicad_sch, display_oled.kicad_sch, microcontroller.kicad_sch, reflow-controller-v1.kicad_pcb, reflow-controller-v1.kicad_sch]
2024-09-06 pcb routing touchups
    [reflow-controller-v1.kicad_pcb]
2024-09-22 small routing improvements
    [reflow-controller-v1.kicad_pcb]
